prepor/rkbrd/3/images/5.jpg

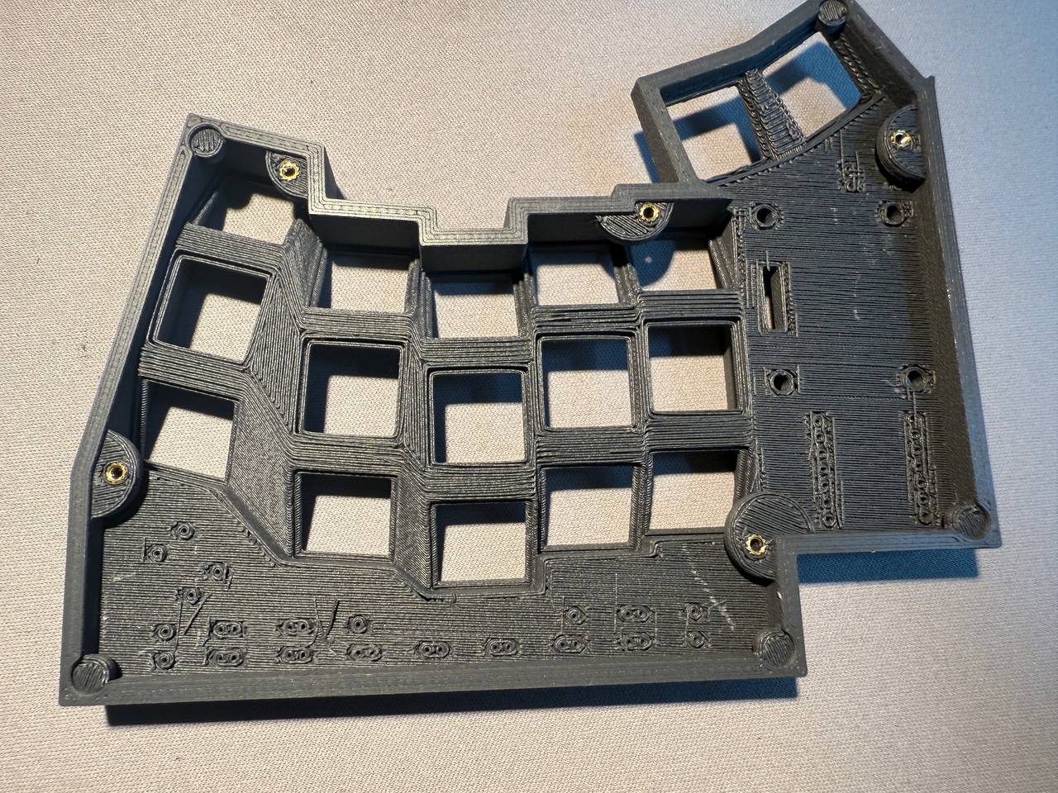
3/images/5.jpg
