prepor/rkbrd/1/pcb/chocopi3d/SMTSOB-M2-2ET-PennEngineering-3D-04-20-2025.stp

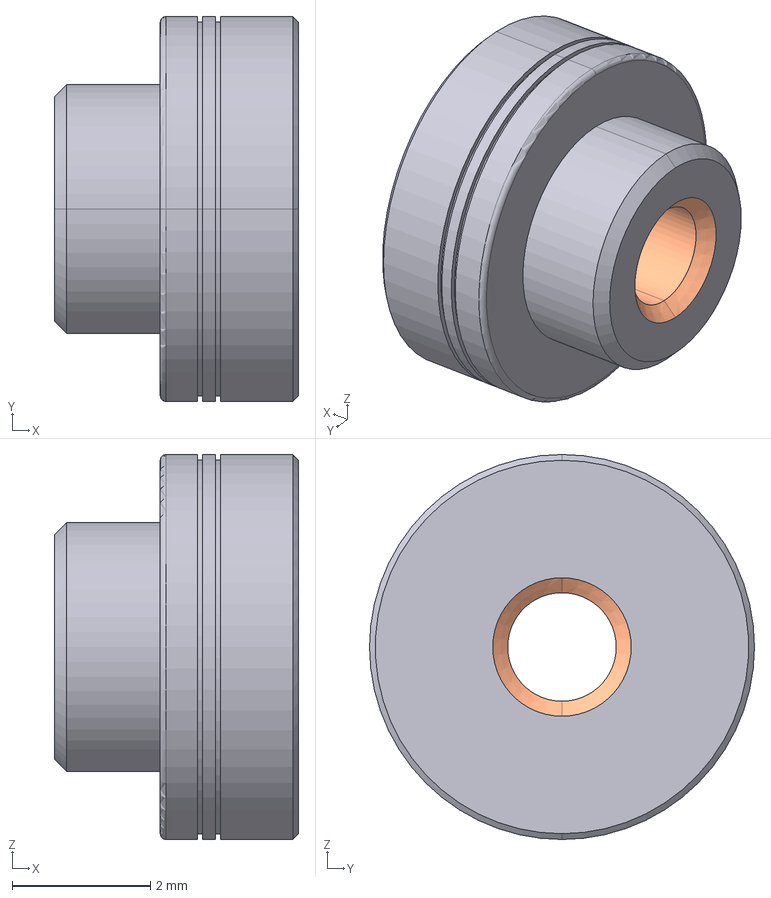
[picture p11: CAD file, 2025-04-21]
1/pcb/chocopi3d/SMTSOB-M2-2ET-PennEngineering-3D-04-20-2025.stp
3.53 x 5.56 x 5.56 mm
