prepor/rkbrd/3/STL/cover.stl

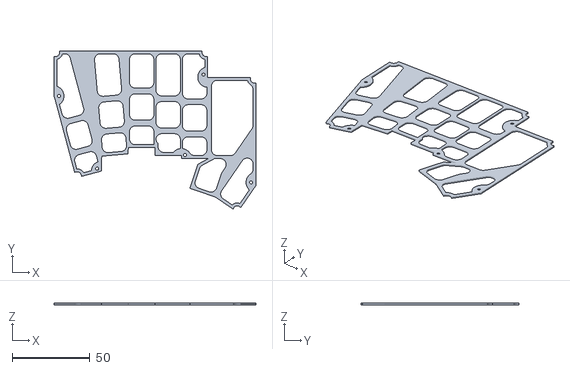
[picture p12: CAD file, 2025-06-05]
3/STL/cover.stl
129.7 x 101.6 x 1.00
