prepor/rkbrd/3/STL/case.stl

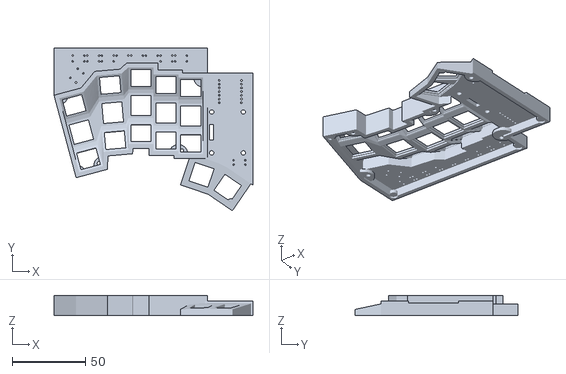
[picture p14: CAD file, 2025-06-05]
3/STL/case.stl
135.9 x 111.0 x 13.8
