prepor/rkbrd/1/pcb/chocopi3d/Cherry_MX_ULP.step

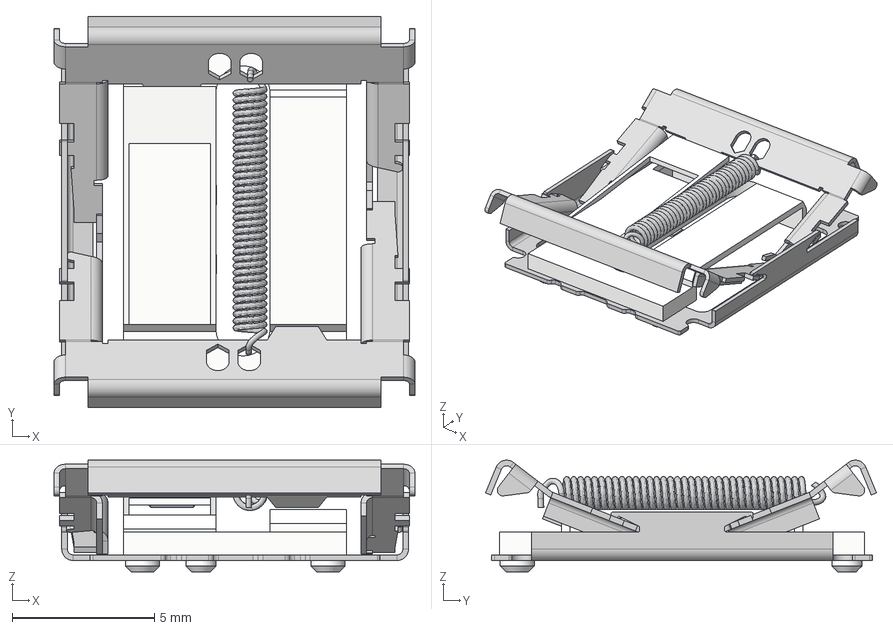
[picture p15: CAD file, 2025-04-19]
1/pcb/chocopi3d/Cherry_MX_ULP.step
12.7 x 13.8 x 3.93 mm
