prepor/rkbrd/1/pcb/chocopi3d/EVQ-P7A01P.step

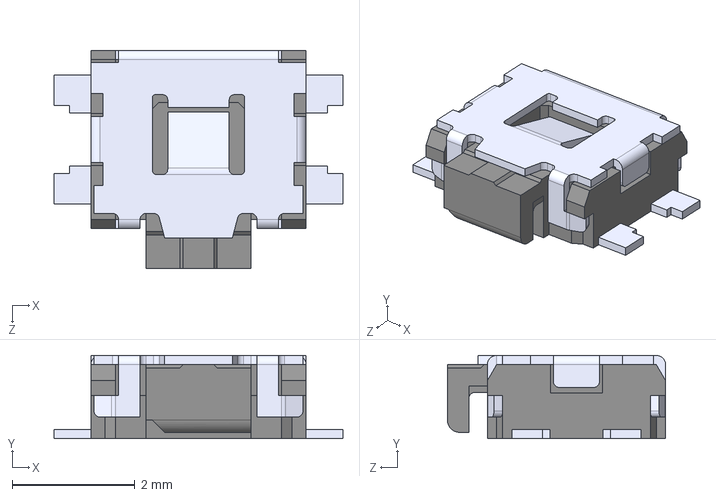
[picture p16: CAD file, 2025-04-19]
1/pcb/chocopi3d/EVQ-P7A01P.step
4.70 x 1.35 x 3.55 mm
