prepor/rkbrd/1/pcb/chocopi3d/MSK12C02.STEP

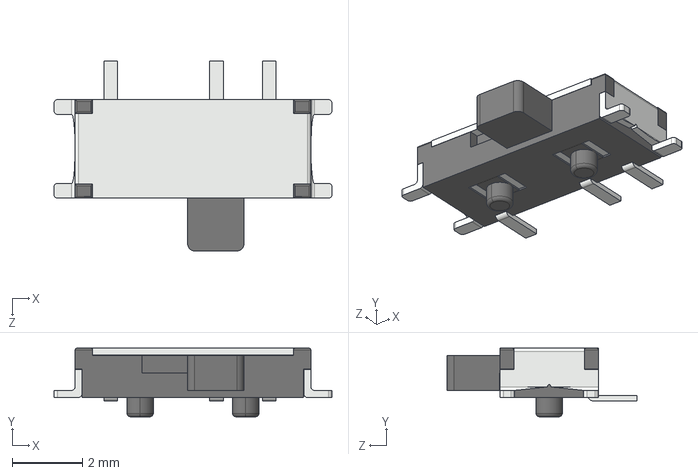
[picture p17: CAD file, 2025-04-19]
1/pcb/chocopi3d/MSK12C02.STEP
7.90 x 1.95 x 5.39 mm
