prepor/rkbrd/1/pcb/chocopi3d/D_SOD-123.step

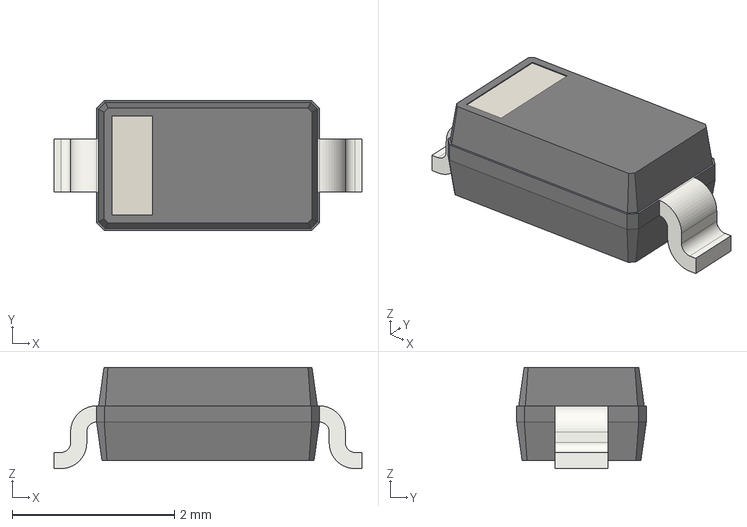
[picture p18: CAD file, 2025-04-19]
1/pcb/chocopi3d/D_SOD-123.step
3.80 x 1.60 x 1.25 mm
