prepor/rkbrd/1/pcb/chocopi3d/SW_SKHLLC.step

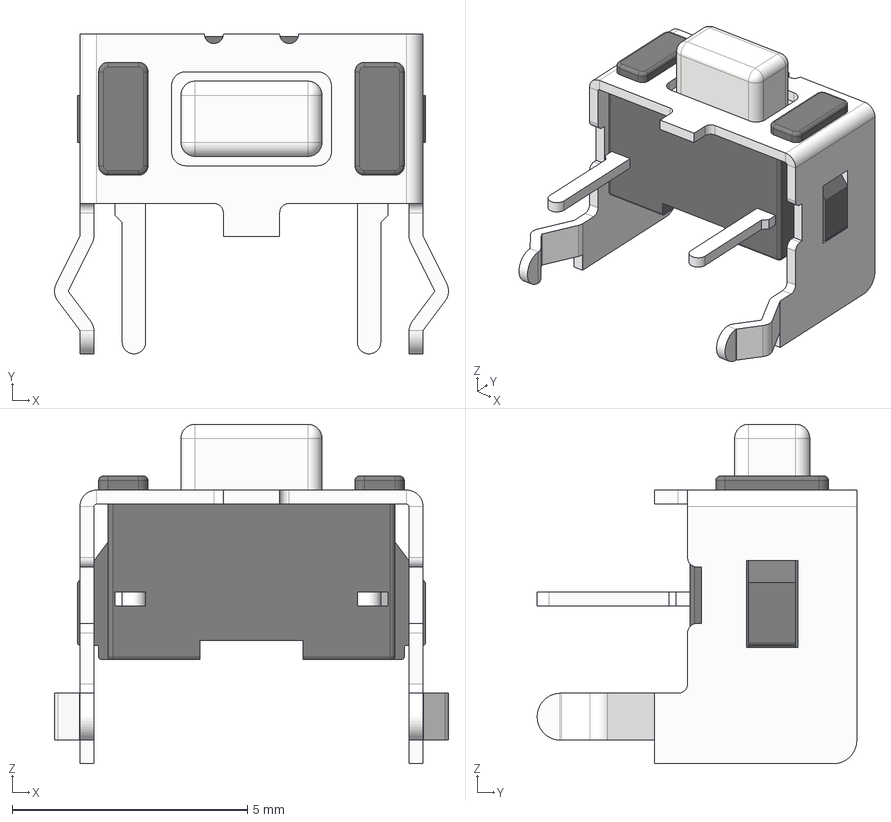
[picture p19: CAD file, 2025-04-19]
1/pcb/chocopi3d/SW_SKHLLC.step
8.38 x 6.80 x 7.22 mm
