prepor/rkbrd/1/pcb/chocopi.kicad_pcb

## KiCad design 1/pcb/chocopi.kicad_pcb (2025-04-21)

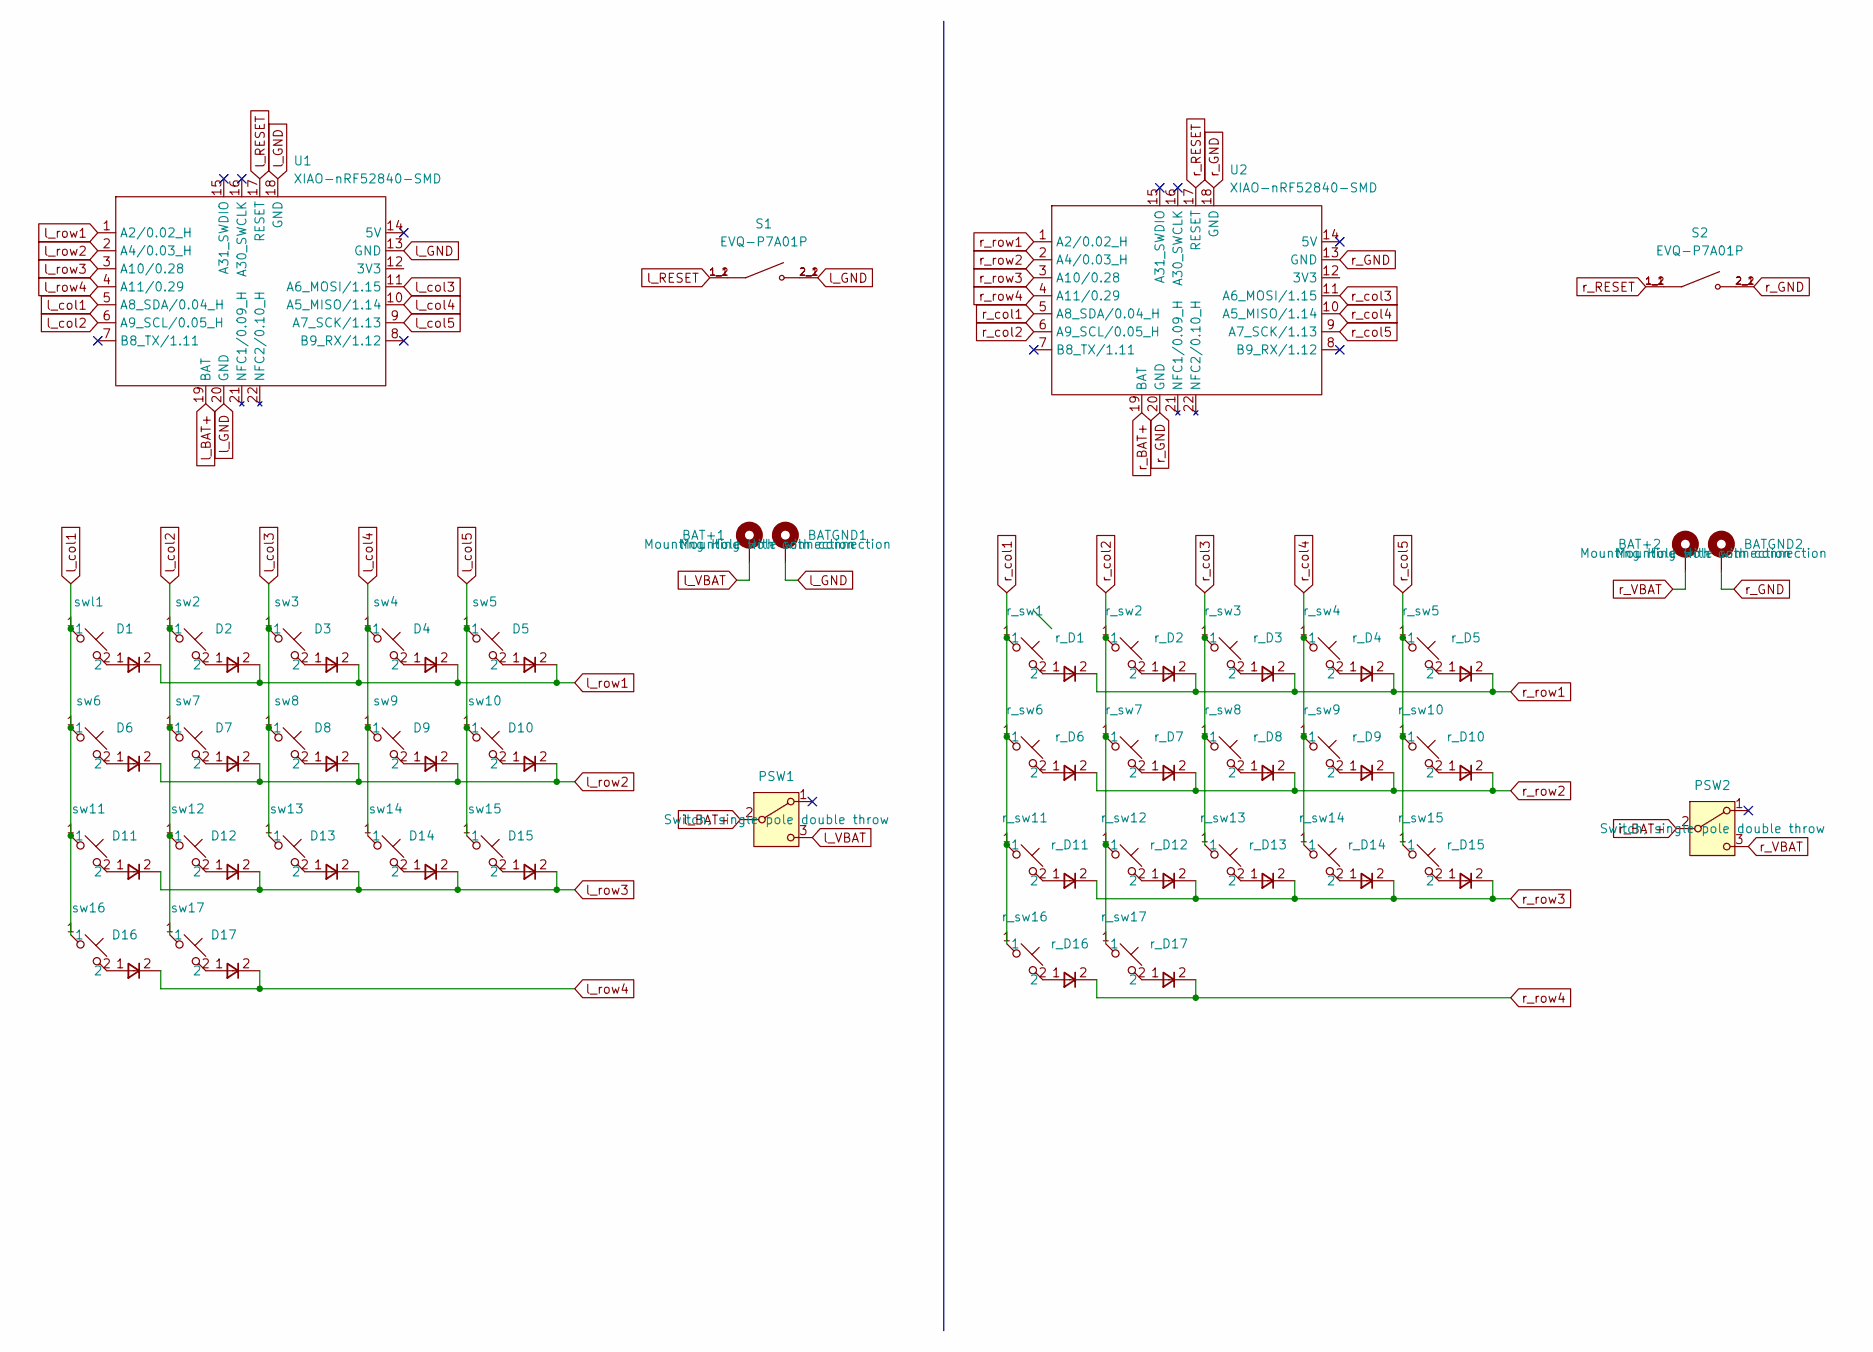
[picture p20: schematic chocopi.kicad_sch]

Parts:
BAT+1, BAT+2: +; BatteryPad
BATGND1, BATGND2: -; BatteryPad
D1, D2, D3, D4, D5, D6, D7, D8, D9, D10, D11, D12, D13, D14, D15, D16, D17: Diode_SOD123
PSW1, PSW2: SW_SPDT; MSK12C02
S1, S2: EVQ-P7A01P; SW_EVQ-P7A01P; PARTREV 2022.4
U1, U2: XIAO-nRF52840-SMD; xiao-ble-smd-cutout
r_D1, r_D2, r_D3, r_D4, r_D5, r_D6, r_D7, r_D8, r_D9, r_D10, r_D11, r_D12, r_D13, r_D14, r_D15, r_D16, r_D17: Diode_SOD123
r_sw1, r_sw2, r_sw3, r_sw4, r_sw5, r_sw6, r_sw7, r_sw8, r_sw9, r_sw10, r_sw11, r_sw12, r_sw13, r_sw14, r_sw15, r_sw16, r_sw17: Cherry_ULP_SMD
sw2, sw3, sw4, sw5, sw6, sw7, sw8, sw9, sw10, sw11, sw12, sw13, sw14, sw15, sw16, sw17: Cherry_ULP_SMD
swl1: Cherry_ULP_SMD

Connections:
unnamed: D1.1 (K), swl1.2
unnamed: D2.1 (K), sw2.2
unnamed: D3.1 (K), sw3.2
unnamed: D4.1 (K), sw4.2
unnamed: D5.1 (K), sw5.2
unnamed: D6.1 (K), sw6.2
unnamed: D7.1 (K), sw7.2
unnamed: D8.1 (K), sw8.2
unnamed: D9.1 (K), sw9.2
unnamed: D10.1 (K), sw10.2
unnamed: D11.1 (K), sw11.2
unnamed: D12.1 (K), sw12.2
unnamed: D13.1 (K), sw13.2
unnamed: D14.1 (K), sw14.2
unnamed: D15.1 (K), sw15.2
unnamed: D16.1 (K), sw16.2
unnamed: D17.1 (K), sw17.2
unnamed: r_D1.1 (K), r_sw1.2
unnamed: r_D2.1 (K), r_sw2.2
unnamed: r_D3.1 (K), r_sw3.2
unnamed: r_D4.1 (K), r_sw4.2
unnamed: r_D5.1 (K), r_sw5.2
unnamed: r_D6.1 (K), r_sw6.2
unnamed: r_D7.1 (K), r_sw7.2
unnamed: r_D8.1 (K), r_sw8.2
unnamed: r_D9.1 (K), r_sw9.2
unnamed: r_D10.1 (K), r_sw10.2
unnamed: r_D11.1 (K), r_sw11.2
unnamed: r_D12.1 (K), r_sw12.2
unnamed: r_D13.1 (K), r_sw13.2
unnamed: r_D14.1 (K), r_sw14.2
unnamed: r_D15.1 (K), r_sw15.2
unnamed: r_D16.1 (K), r_sw16.2
unnamed: r_D17.1 (K), r_sw17.2
l_BAT+: PSW1.2 (B), U1.19 (BAT)
l_GND: BATGND1.1, S1.2_1, S1.2_2, U1.13 (GND), U1.18 (GND), U1.20 (GND)
l_RESET: S1.1_1, S1.1_2, U1.17 (RESET)
l_VBAT: BAT+1.1, PSW1.3 (C)
l_col1: U1.5 (A8_SDA/0.04_H), sw6.1, sw11.1, sw16.1, swl1.1
l_col2: U1.6 (A9_SCL/0.05_H), sw2.1, sw7.1, sw12.1, sw17.1
l_col3: U1.11 (A6_MOSI/1.15), sw3.1, sw8.1, sw13.1
l_col4: U1.10 (A5_MISO/1.14), sw4.1, sw9.1, sw14.1
l_col5: U1.9 (A7_SCK/1.13), sw5.1, sw10.1, sw15.1
l_row1: D1.2 (A), D2.2 (A), D3.2 (A), D4.2 (A), D5.2 (A), U1.1 (A2/0.02_H)
l_row2: D6.2 (A), D7.2 (A), D8.2 (A), D9.2 (A), D10.2 (A), U1.2 (A4/0.03_H)
l_row3: D11.2 (A), D12.2 (A), D13.2 (A), D14.2 (A), D15.2 (A), U1.3 (A10/0.28)
l_row4: D16.2 (A), D17.2 (A), U1.4 (A11/0.29)
r_BAT+: PSW2.2 (B), U2.19 (BAT)
r_GND: BATGND2.1, S2.2_1, S2.2_2, U2.13 (GND), U2.18 (GND), U2.20 (GND)
r_RESET: S2.1_1, S2.1_2, U2.17 (RESET)
r_VBAT: BAT+2.1, PSW2.3 (C)
r_col1: U2.5 (A8_SDA/0.04_H), r_sw1.1, r_sw6.1, r_sw11.1, r_sw16.1
r_col2: U2.6 (A9_SCL/0.05_H), r_sw2.1, r_sw7.1, r_sw12.1, r_sw17.1
r_col3: U2.11 (A6_MOSI/1.15), r_sw3.1, r_sw8.1, r_sw13.1
r_col4: U2.10 (A5_MISO/1.14), r_sw4.1, r_sw9.1, r_sw14.1
r_col5: U2.9 (A7_SCK/1.13), r_sw5.1, r_sw10.1, r_sw15.1
r_row1: U2.1 (A2/0.02_H), r_D1.2 (A), r_D2.2 (A), r_D3.2 (A), r_D4.2 (A), r_D5.2 (A)
r_row2: r_D6.2 (A), r_D7.2 (A), r_D8.2 (A), r_D9.2 (A), r_D10.2 (A)
r_row2: U2.2 (A4/0.03_H)
r_row3: U2.3 (A10/0.28), r_D11.2 (A), r_D12.2 (A), r_D13.2 (A), r_D14.2 (A), r_D15.2 (A)
r_row4: U2.4 (A11/0.29), r_D16.2 (A), r_D17.2 (A)

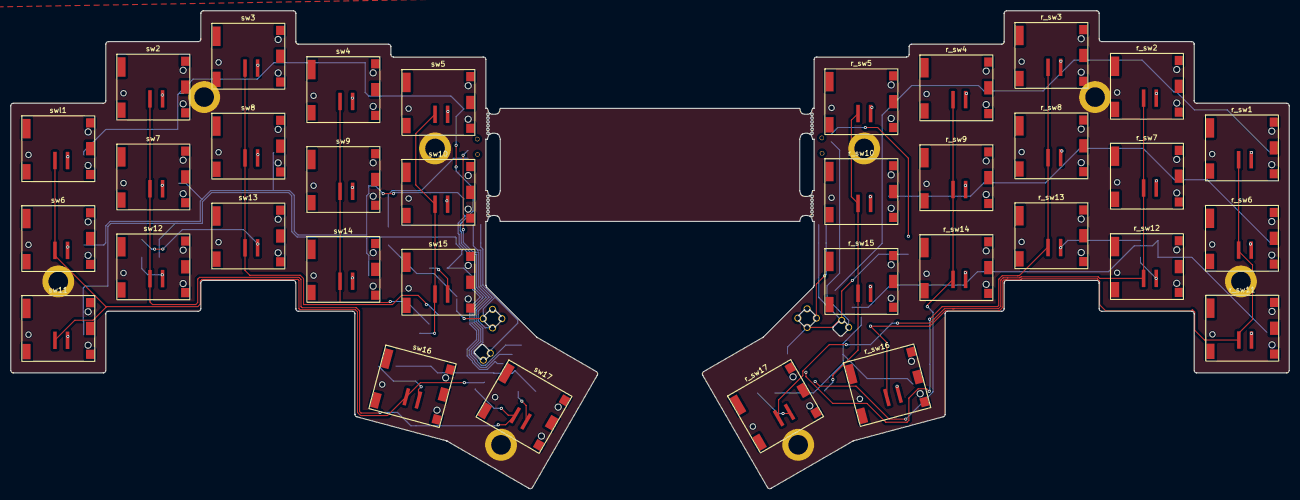
[picture p21: board chocopi.kicad_pcb from above]

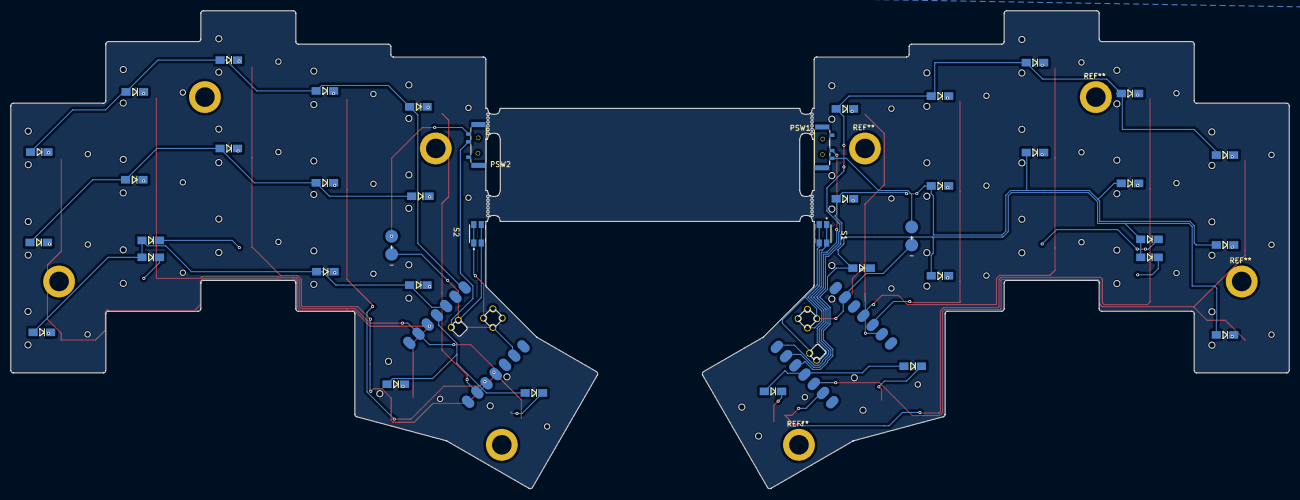
[picture p22: board chocopi.kicad_pcb from below]

Board: 2 copper layers, 248.9 x 93.1 mm, 78 parts (44 on the bottom side), 60 nets.
