prepor/rkbrd/(commit log)

2025-04-19 fix diode
    [chocopi.kicad_pcb]
2025-06-05 rkbrd3 init
    [case.stl, cover.stl]
